shxshxshxshx/VoronToolheadPCB/README.md

USB Toolhead Board for Voron Stealthburner

**WIP | DO NOT ORDER**

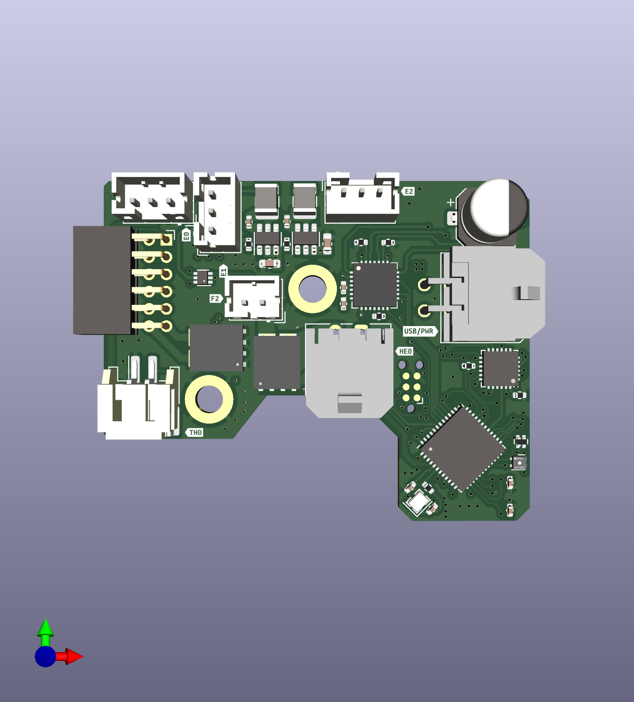
[picture p1: img/VoronToolheadPCB_Front.png]
Main PCB Front

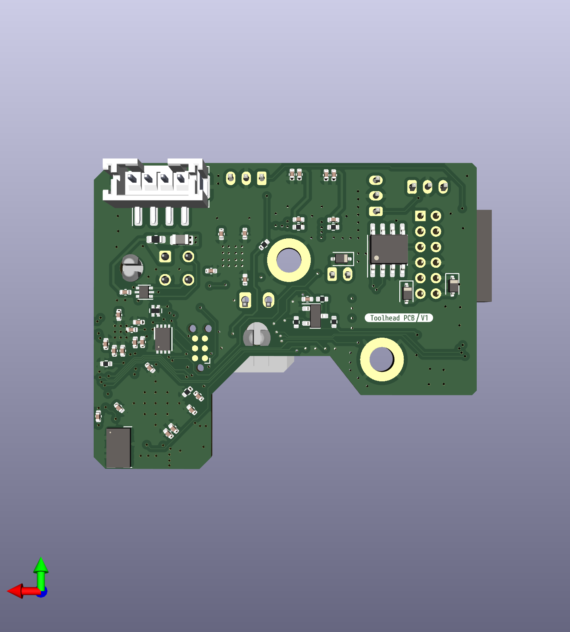
[picture p2: img/VoronToolheadPCB_Back.png]
Main PCB Back
