shxshxshxshx/VoronToolheadPCB/VoronToolheadPCB.kicad_pcb

## KiCad design VoronToolheadPCB.kicad_pcb (2023-10-27)

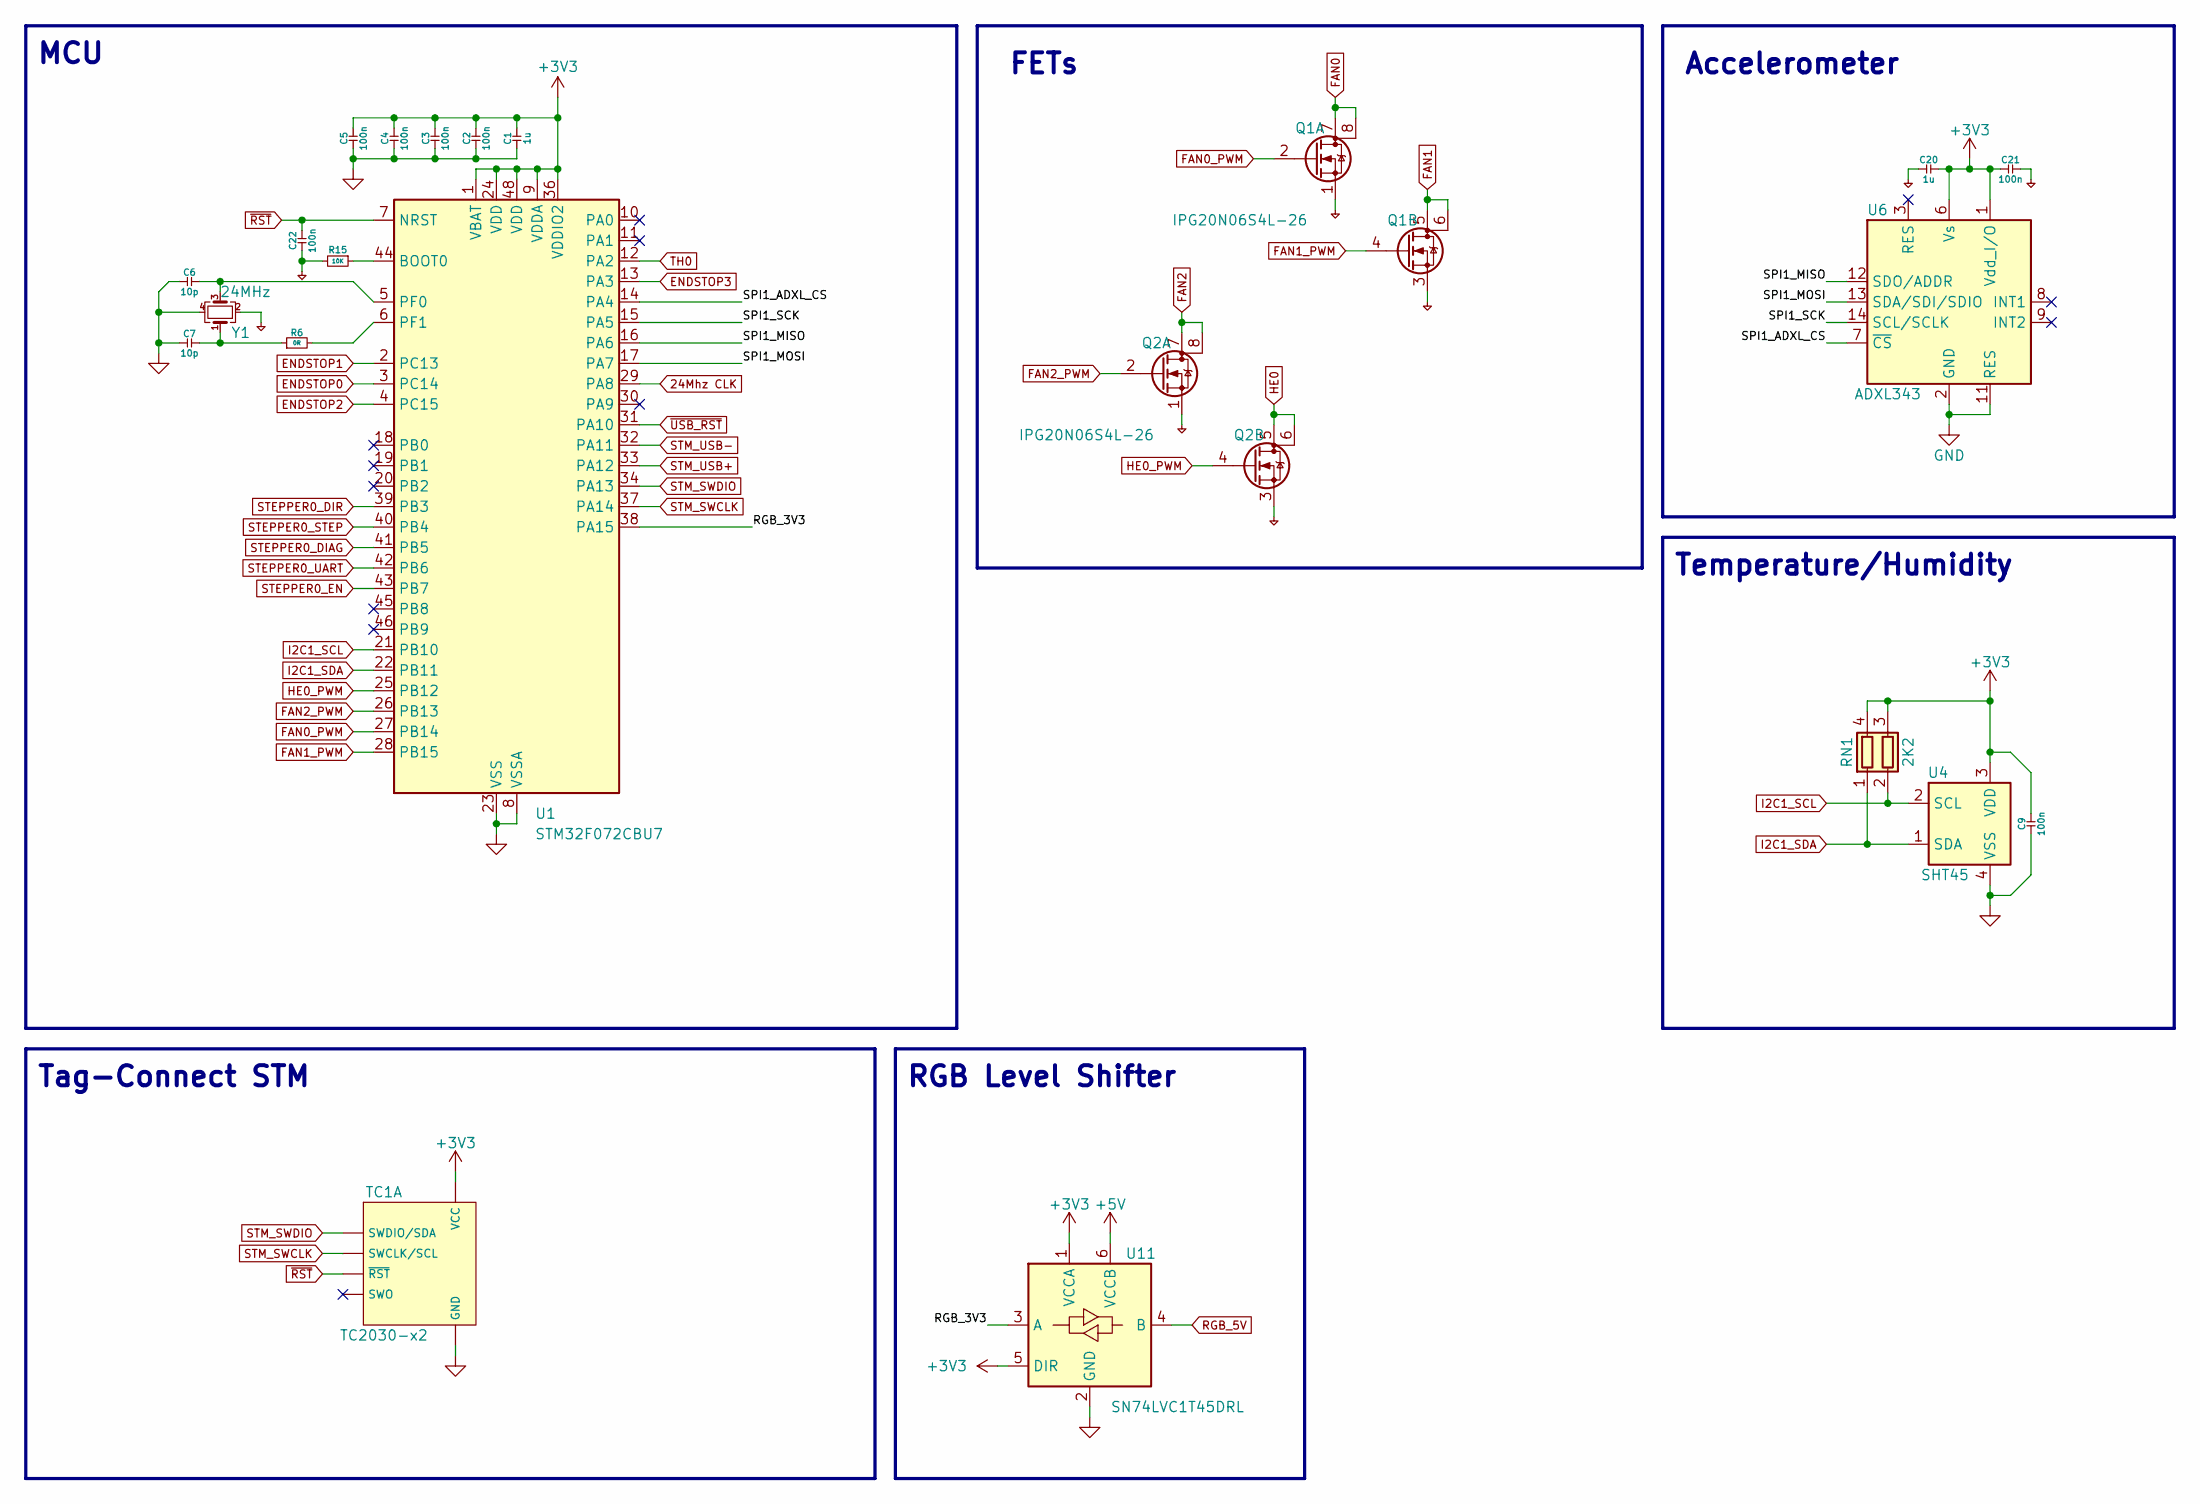
[picture p3: schematic mcu.kicad_sch]

Parts:
C1, C20: 1u; C_0402_1005Metric
C2, C3, C4, C5, C9, C21, C22: 100n; C_0402_1005Metric
C6, C7: 10p; C_0402_1005Metric
Q1, Q2: IPG20N06S4L-26; Infineon_PG-TDSON-8-4
R6: 0R; R_0402_1005Metric
R15: 10K; R_0402_1005Metric
RN1: 2K2; R_Array_Convex_2x0402
TC1: TC2030-x2; Double_Tag-Connect_TC2030-IDC-NL
U1: STM32F072CBU7; QFN-48-1EP_7x7mm_P0.5mm_EP5.6x5.6mm
U4: SHT45; Sensirion_DFN-4_1.5x1.5mm_P0.8mm_SHT4x_NoCentralPad
U6: ADXL343; LGA-14_3x5mm_P0.8mm_LayoutBorder1x6y
U11: SN74LVC1T45DRL; SOT-563
Y1: 24MHz; Crystal_SMD_2016-4Pin_2.0x1.6mm

Connections:
24Mhz CLK: U1.29 (PA8); also elsewhere on the board
+3V3: C1.2, C2.2, C3.2, C4.2, C5.2, C9.2, C20.2, C21.1, RN1.3 (R2.2), RN1.4 (R1.2), TC1.1 (VCC), U1.1 (VBAT), U1.9 (VDDA), U1.24 (VDD), U1.36 (VDDIO2), U1.48 (VDD), U4.3 (VDD), U6.1 (Vdd_I/O), U6.6 (Vs), U11.1 (VCCA), U11.5 (DIR); also elsewhere on the board
+5V: U11.6 (VCCB); also elsewhere on the board
/MCU/RGB_3V3: U1.38 (PA15), U11.3 (A)
/MCU/SPI1_ADXL_CS: U1.14 (PA4), U6.7 (~CS)
/MCU/SPI1_MISO: U1.16 (PA6), U6.12 (SDO/ADDR)
/MCU/SPI1_MOSI: U1.17 (PA7), U6.13 (SDA/SDI/SDIO)
/MCU/SPI1_SCK: U1.15 (PA5), U6.14 (SCL/SCLK)
ENDSTOP0: U1.3 (PC14); also elsewhere on the board
ENDSTOP1: U1.2 (PC13); also elsewhere on the board
ENDSTOP2: U1.4 (PC15); also elsewhere on the board
ENDSTOP3: U1.13 (PA3); also elsewhere on the board
FAN0: Q1.7 (D), Q1.8 (D); also elsewhere on the board
FAN0_PWM: Q1.2 (G), U1.27 (PB14)
FAN1: Q1.5 (D), Q1.6 (D); also elsewhere on the board
FAN1_PWM: Q1.4 (G), U1.28 (PB15)
FAN2: Q2.7 (D), Q2.8 (D); also elsewhere on the board
FAN2_PWM: Q2.2 (G), U1.26 (PB13)
GND: C1.1, C2.1, C3.1, C4.1, C5.1, C6.1, C7.1, C9.1, C20.1, C21.2, C22.1, Q1.1 (S), Q1.3 (S), Q2.1 (S), Q2.3 (S), R15.2, TC1.5 (GND), U1.8 (VSSA), U1.23 (VSS), U1.35 (VSS), U1.47 (VSS), U1.49 (VSS), U4.4 (VSS), U6.2 (GND), U6.4 (GND), U6.5 (GND), U6.11 (RES), U11.2 (GND), Y1.2, Y1.4; also elsewhere on the board
HE0: Q2.5 (D), Q2.6 (D); also elsewhere on the board
HE0_PWM: Q2.4 (G), U1.25 (PB12)
I2C1_SCL: RN1.2 (R2.1), U1.21 (PB10), U4.2 (SCL)
I2C1_SDA: RN1.1 (R1.1), U1.22 (PB11), U4.1 (SDA)
unnamed: C7.2, R6.1, Y1.1
unnamed: R15.1, U1.44 (BOOT0)
unnamed: C6.2, U1.5 (PF0), Y1.3
unnamed: R6.2, U1.6 (PF1)
RGB_5V: U11.4 (B); also elsewhere on the board
STEPPER0_DIAG: U1.41 (PB5); also elsewhere on the board
STEPPER0_DIR: U1.39 (PB3); also elsewhere on the board
STEPPER0_EN: U1.43 (PB7); also elsewhere on the board
STEPPER0_STEP: U1.40 (PB4); also elsewhere on the board
STEPPER0_UART: U1.42 (PB6); also elsewhere on the board
STM_SWCLK: TC1.4 (SWCLK/SCL), U1.37 (PA14)
STM_SWDIO: TC1.2 (SWDIO/SDA), U1.34 (PA13)
STM_USB+: U1.33 (PA12); also elsewhere on the board
STM_USB-: U1.32 (PA11); also elsewhere on the board
TH0: U1.12 (PA2); also elsewhere on the board
~RST: C22.2, TC1.3 (~RST), U1.7 (NRST)
~USB_RST: U1.31 (PA10); also elsewhere on the board

Notes on the sheet:
MCU
Tag-Connect STM
Accelerometer
Temperature/Humidity
FETs
RGB Level Shifter

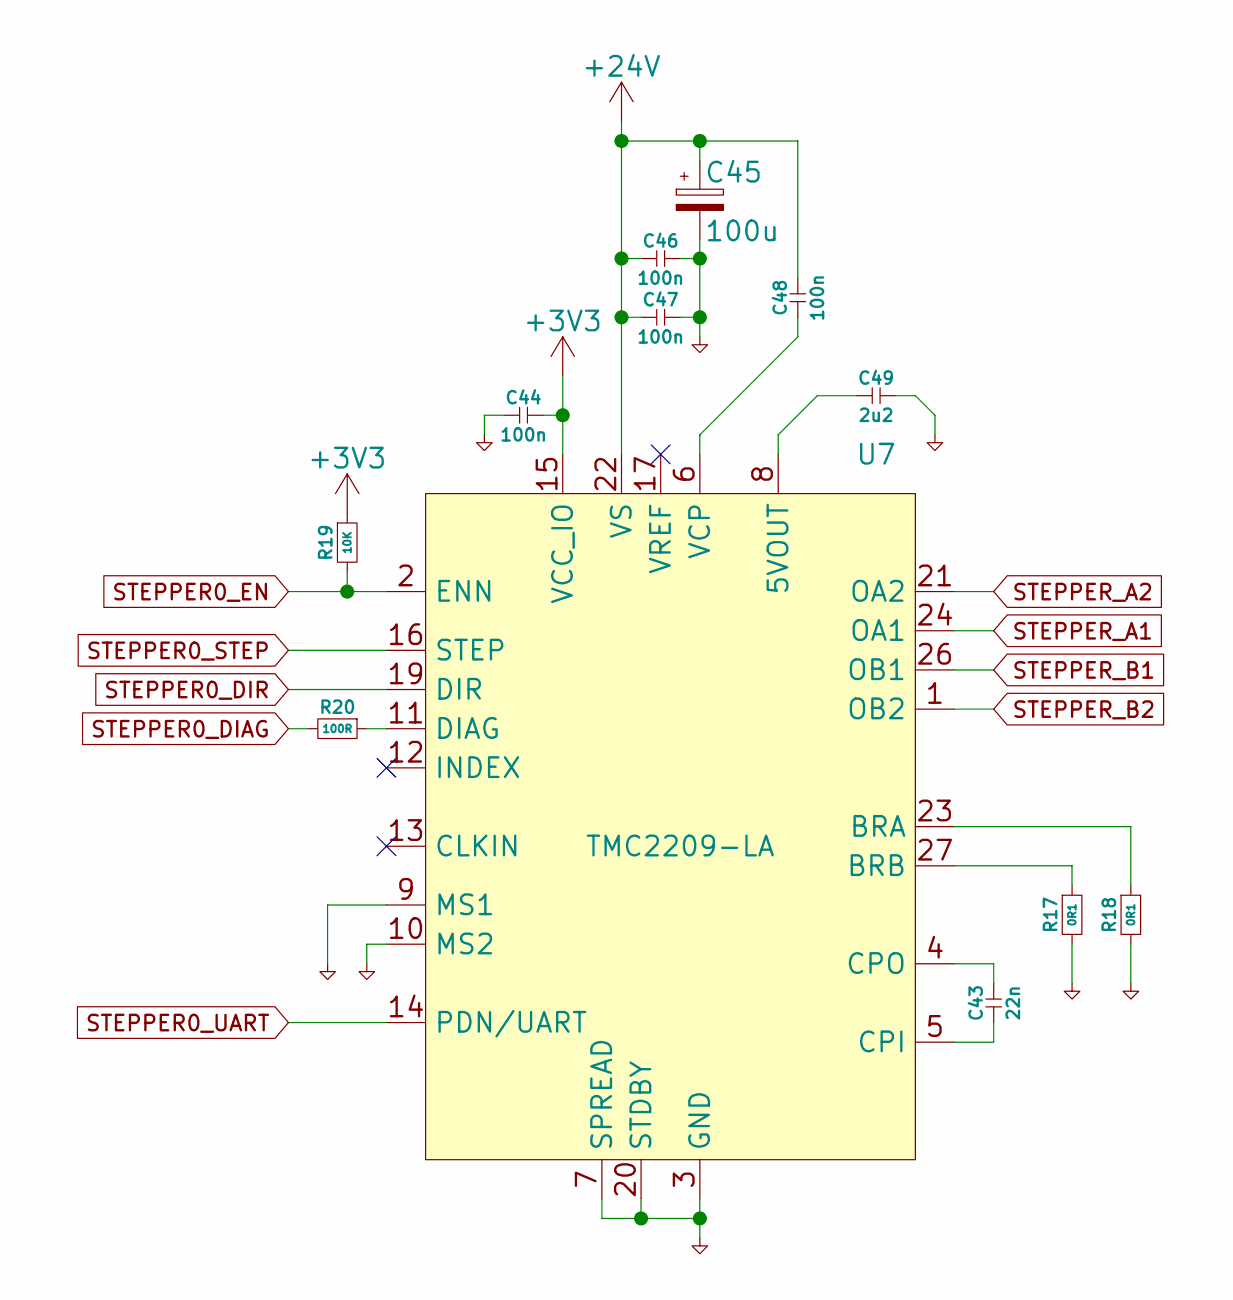
[picture p4: schematic stepper.kicad_sch]

Parts:
C43: 22n; C_0402_1005Metric
C44, C46, C47, C48: 100n; C_0402_1005Metric
C45: 100u; CP_Elec_6.3x7.7
C49: 2u2; C_0402_1005Metric
R17, R18: 0R1; R_0402_1005Metric
R19: 10K; R_0402_1005Metric
R20: 100R; R_0402_1005Metric
U7: TMC2209-LA; QFN-28-1EP_5x5mm_P0.5mm_EP3.75x3.75mm

Connections:
+3V3: C44.2, R19.1, U7.15 (VCC_IO); also elsewhere on the board
+24V: C45.1, C46.1, C47.1, C48.2, U7.22 (VS), U7.28 (VS); also elsewhere on the board
GND: C44.1, C45.2, C46.2, C47.2, C49.2, R17.2, R18.2, U7.3 (GND), U7.7 (SPREAD), U7.9 (MS1), U7.10 (MS2), U7.18 (GND), U7.20 (STDBY), U7.25, U7.29 (EP); also elsewhere on the board
unnamed: C49.1, U7.8 (5VOUT)
unnamed: R18.1, U7.23 (BRA)
unnamed: R17.1, U7.27 (BRB)
unnamed: C43.1, U7.5 (CPI)
unnamed: C43.2, U7.4 (CPO)
unnamed: R20.1, U7.11 (DIAG)
unnamed: C48.1, U7.6 (VCP)
STEPPER0_DIAG: R20.2; also elsewhere on the board
STEPPER0_DIR: U7.19 (DIR); also elsewhere on the board
STEPPER0_EN: R19.2, U7.2 (ENN); also elsewhere on the board
STEPPER0_STEP: U7.16 (STEP); also elsewhere on the board
STEPPER0_UART: U7.14 (PDN/UART); also elsewhere on the board
STEPPER_A1: U7.24 (OA1); also elsewhere on the board
STEPPER_A2: U7.21 (OA2); also elsewhere on the board
STEPPER_B1: U7.26 (OB1); also elsewhere on the board
STEPPER_B2: U7.1 (OB2); also elsewhere on the board

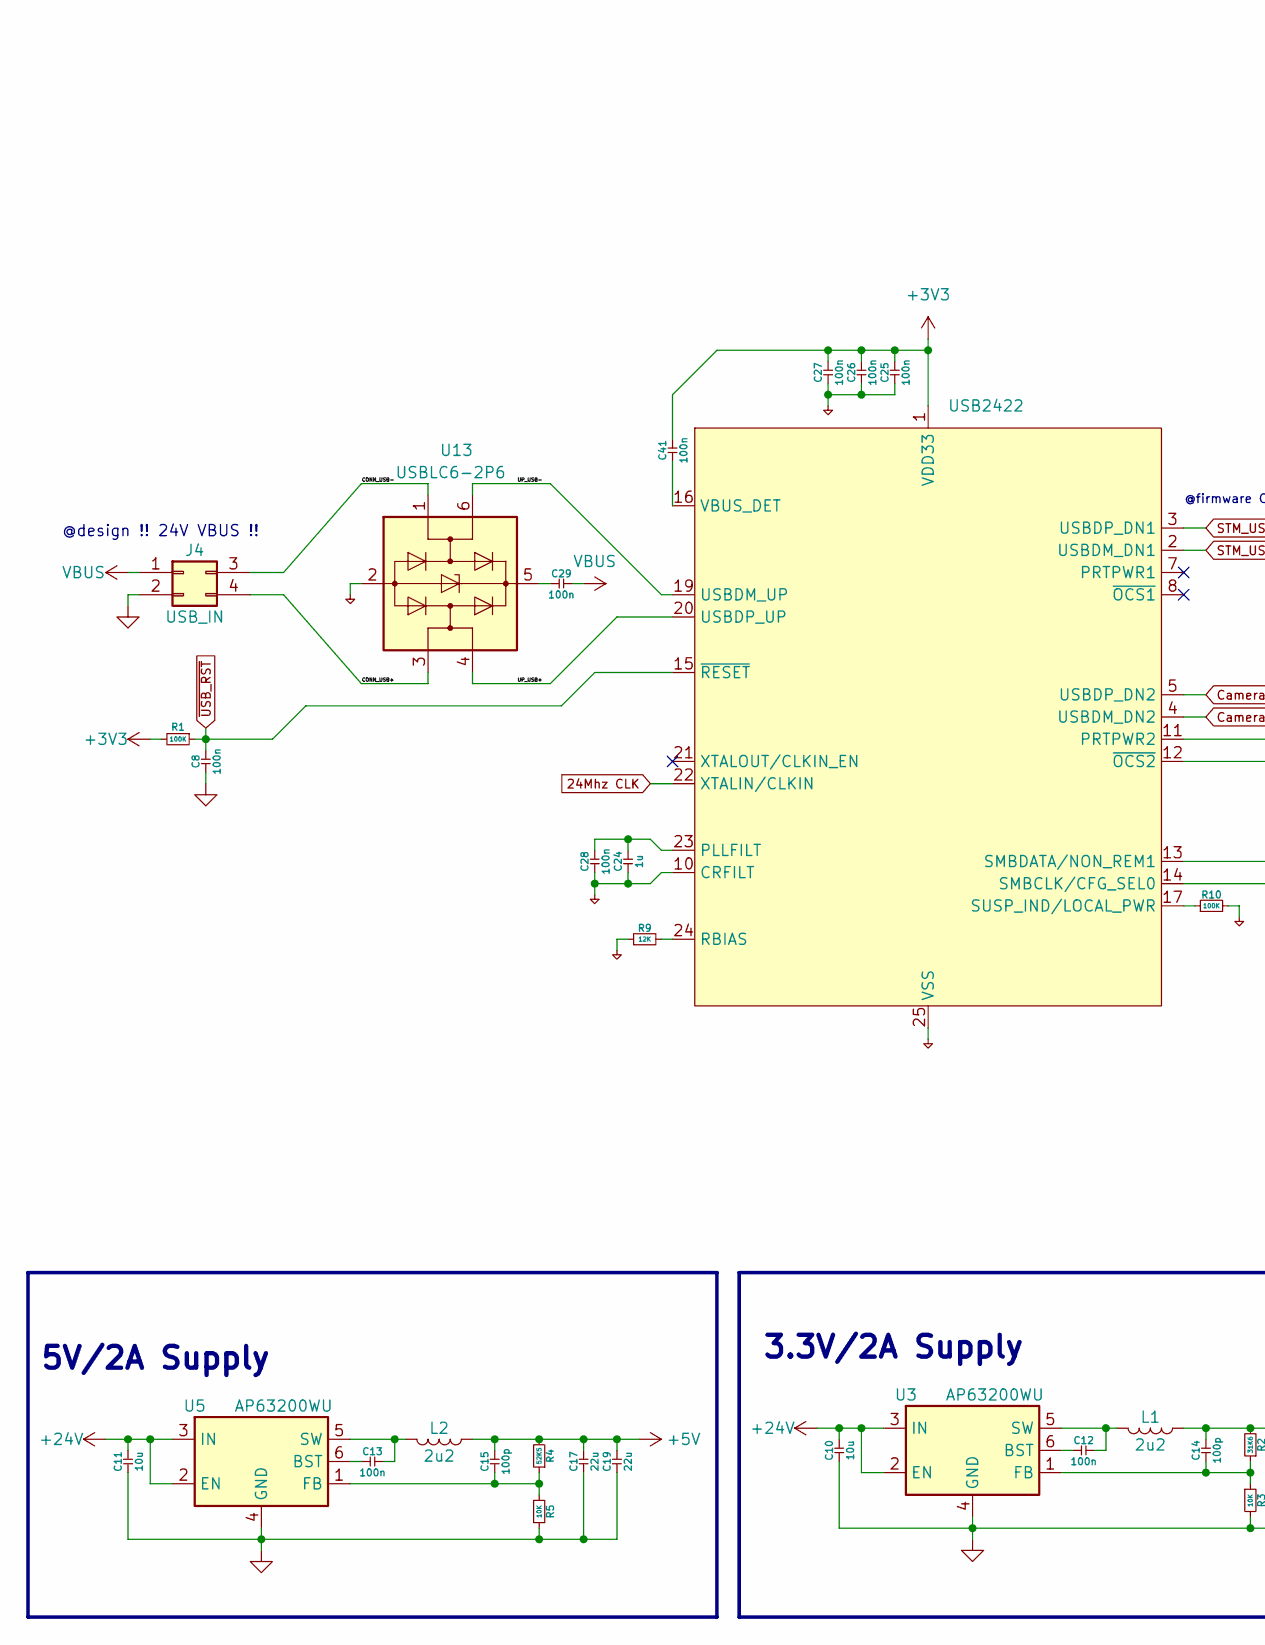
[picture p5: schematic usb.kicad_sch, part in row 1, column 1]

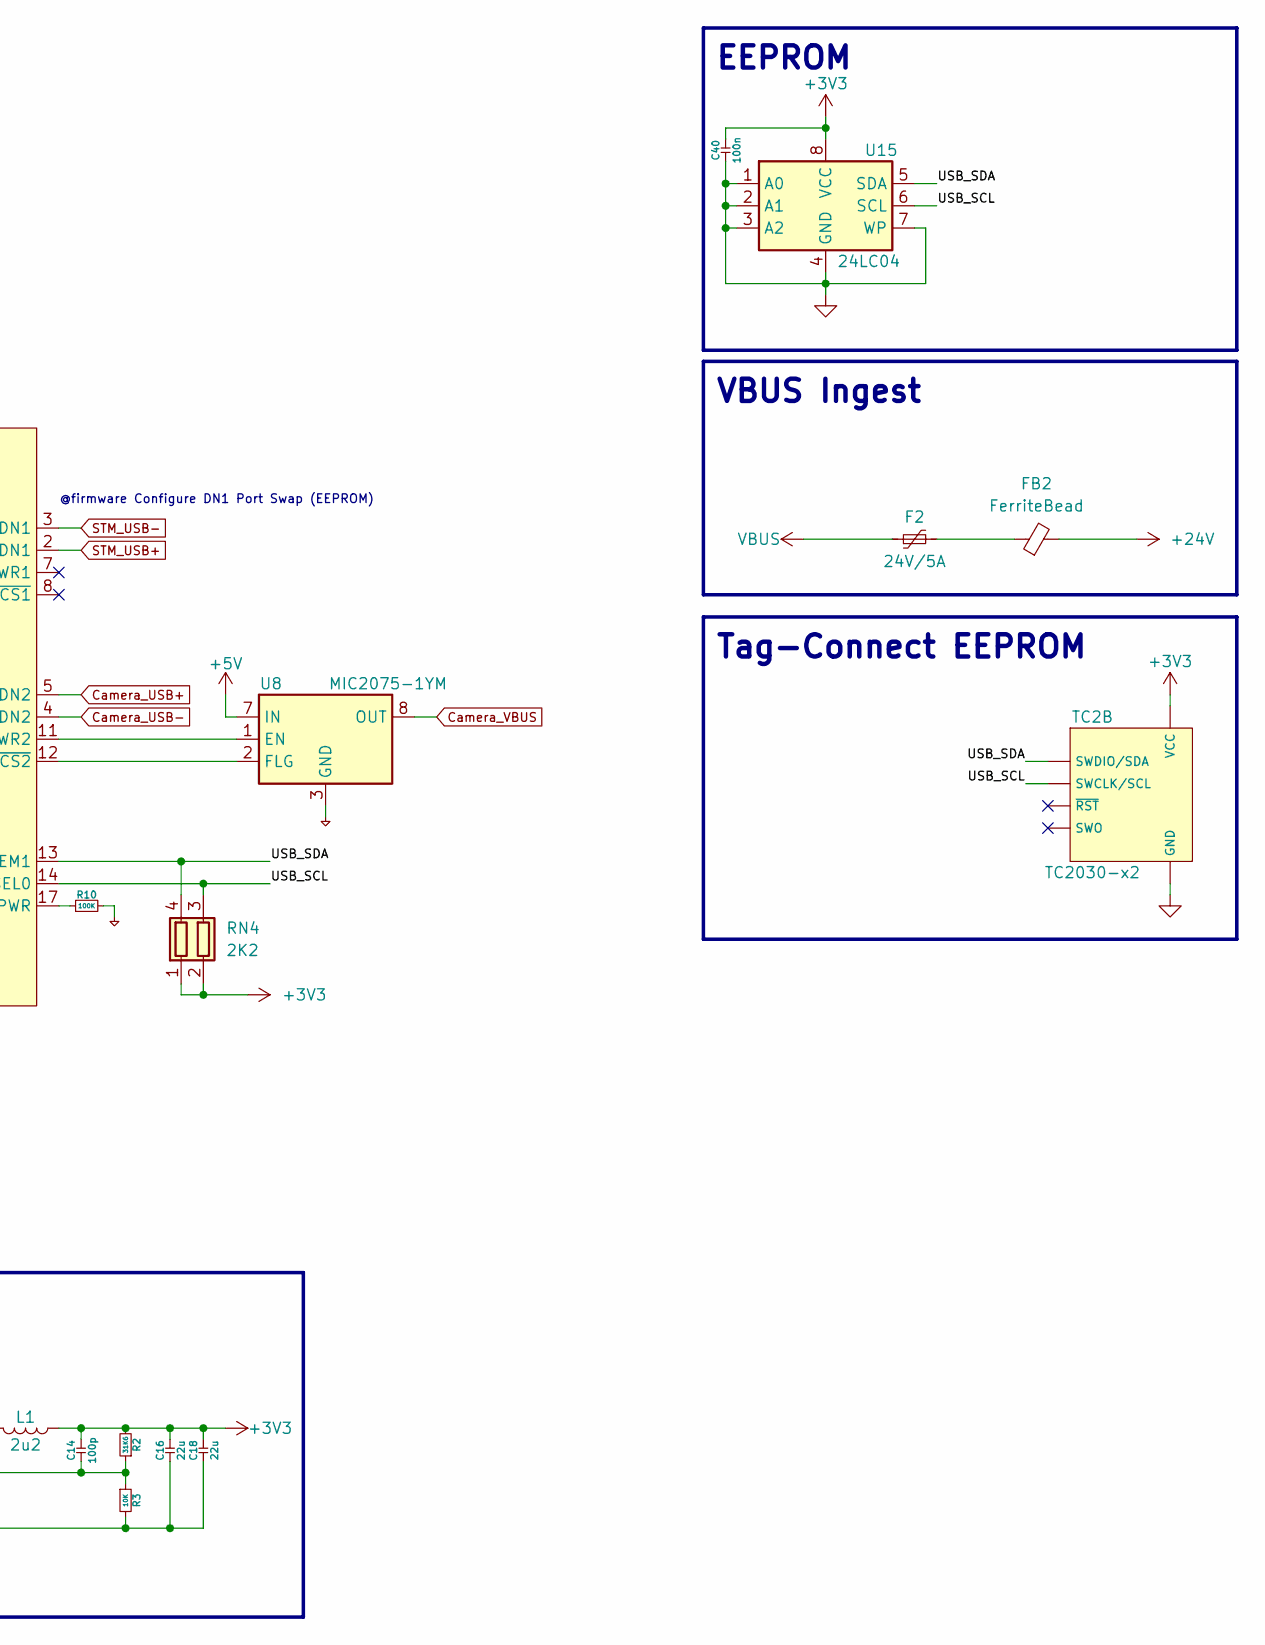
[picture p6: schematic usb.kicad_sch, part in row 1, column 2]

Parts:
C8, C12, C13, C25, C26, C27, C28, C29, C40, C41: 100n; C_0402_1005Metric
C10, C11: 10u; C_0603_1608Metric
C14, C15: 100p; C_0402_1005Metric
C16, C17, C18, C19: 22u; C_0402_1005Metric
C24: 1u; C_0402_1005Metric
F2: 24V/5A; Fuse_0603_1608Metric
FB2: FerriteBead; L_0805_2012Metric
J4: USB_IN; Molex_Micro-Fit_3.0_43045-0400_2x02_P3.00mm_Horizontal
L1, L2: 2u2; L_1210_3225Metric
R1, R10: 100K; R_0402_1005Metric
R2: 31K6; R_0402_1005Metric
R3, R5: 10K; R_0402_1005Metric
R4: 52K5; R_0402_1005Metric
R9: 12K; R_0402_1005Metric
RN4: 2K2; R_Array_Convex_2x0402
TC2: TC2030-x2; Double_Tag-Connect_TC2030-IDC-NL
U2: USB2422; QFN-24-1EP_4x4mm_P0.5mm_EP2.6x2.6mm
U3, U5: AP63200WU; TSOT-23-6
U8: MIC2075-1YM; SOIC-8_3.9x4.9mm_P1.27mm
U13: USBLC6-2P6; SOT-666
U15: 24LC04; DFN-8-1EP_3x2mm_P0.5mm_EP1.36x1.46mm

Connections:
24Mhz CLK: U2.22 (XTALIN/CLKIN); also elsewhere on the board
+3V3: C14.2, C16.2, C18.2, C25.2, C26.2, C27.2, C40.2, C41.2, L1.1, R1.2, R2.2, RN4.1 (R1.1), RN4.2 (R2.1), U2.1 (VDD33), U2.9 (VDD33), U2.18 (VDD33), U15.8 (VCC); also elsewhere on the board
+5V: C15.2, C17.2, C19.2, L2.2, R4.2, U8.7 (IN); also elsewhere on the board
+24V: C10.2, C11.2, FB2.2, U3.2 (EN), U3.3 (IN), U5.2 (EN), U5.3 (IN); also elsewhere on the board
/USB/CONN_USB+: J4.4, U13.3 (I/O2)
/USB/CONN_USB-: J4.3, U13.1 (I/O1)
/USB/UP_USB+: U2.20 (USBDP_UP), U13.4 (I/O2)
/USB/UP_USB-: U2.19 (USBDM_UP), U13.6 (I/O1)
/USB/USB_SCL: RN4.3 (R2.2), U2.14 (SMBCLK/CFG_SEL0), U15.6 (SCL); also elsewhere on the board
/USB/USB_SDA: RN4.4 (R1.2), U2.13 (SMBDATA/NON_REM1), U15.5 (SDA); also elsewhere on the board
Camera_USB+: U2.5 (USBDP_DN2); also elsewhere on the board
Camera_USB-: U2.4 (USBDM_DN2); also elsewhere on the board
Camera_VBUS: U8.6 (OUT), U8.8 (OUT); also elsewhere on the board
GND: C8.1, C10.1, C11.1, C16.1, C17.1, C18.1, C19.1, C24.1, C25.1, C26.1, C27.1, C28.1, C40.1, J4.2, R3.2, R5.2, R9.1, R10.2, U2.10 (CRFILT), U2.25 (VSS), U3.4 (GND), U5.4 (GND), U8.3 (GND), U13.2 (GND), U15.1 (A0), U15.2 (A1), U15.3 (A2), U15.4 (GND), U15.7 (WP), U15.9; also elsewhere on the board
unnamed: F2.2, FB2.1
unnamed: C24.2, C28.2, U2.23 (PLLFILT)
unnamed: U2.11 (PRTPWR2), U8.1 (EN)
unnamed: R9.2, U2.24 (RBIAS)
unnamed: R10.1, U2.17 (SUSP_IND/LOCAL_PWR)
unnamed: C41.1, U2.16 (VBUS_DET)
unnamed: U2.12 (~OCS2), U8.2 (FLG)
unnamed: C12.1, U3.6 (BST)
unnamed: C14.1, R2.1, R3.1, U3.1 (FB)
unnamed: C12.2, L1.2, U3.5 (SW)
unnamed: C13.1, U5.6 (BST)
unnamed: C15.1, R4.1, R5.1, U5.1 (FB)
unnamed: C13.2, L2.1, U5.5 (SW)
unnamed: C29.1, U13.5 (VBUS)
STM_USB+: U2.2 (USBDM_DN1); also elsewhere on the board
STM_USB-: U2.3 (USBDP_DN1); also elsewhere on the board
VBUS: C29.2, F2.1, J4.1
~USB_RST: C8.2, R1.1, U2.15 (~RESET); also elsewhere on the board

Notes on the sheet:
@design !! 24V VBUS !!
VBUS Ingest
3.3V/2A Supply
5V/2A Supply
EEPROM
Tag-Connect EEPROM
@firmware Configure DN1 Port Swap (EEPROM)

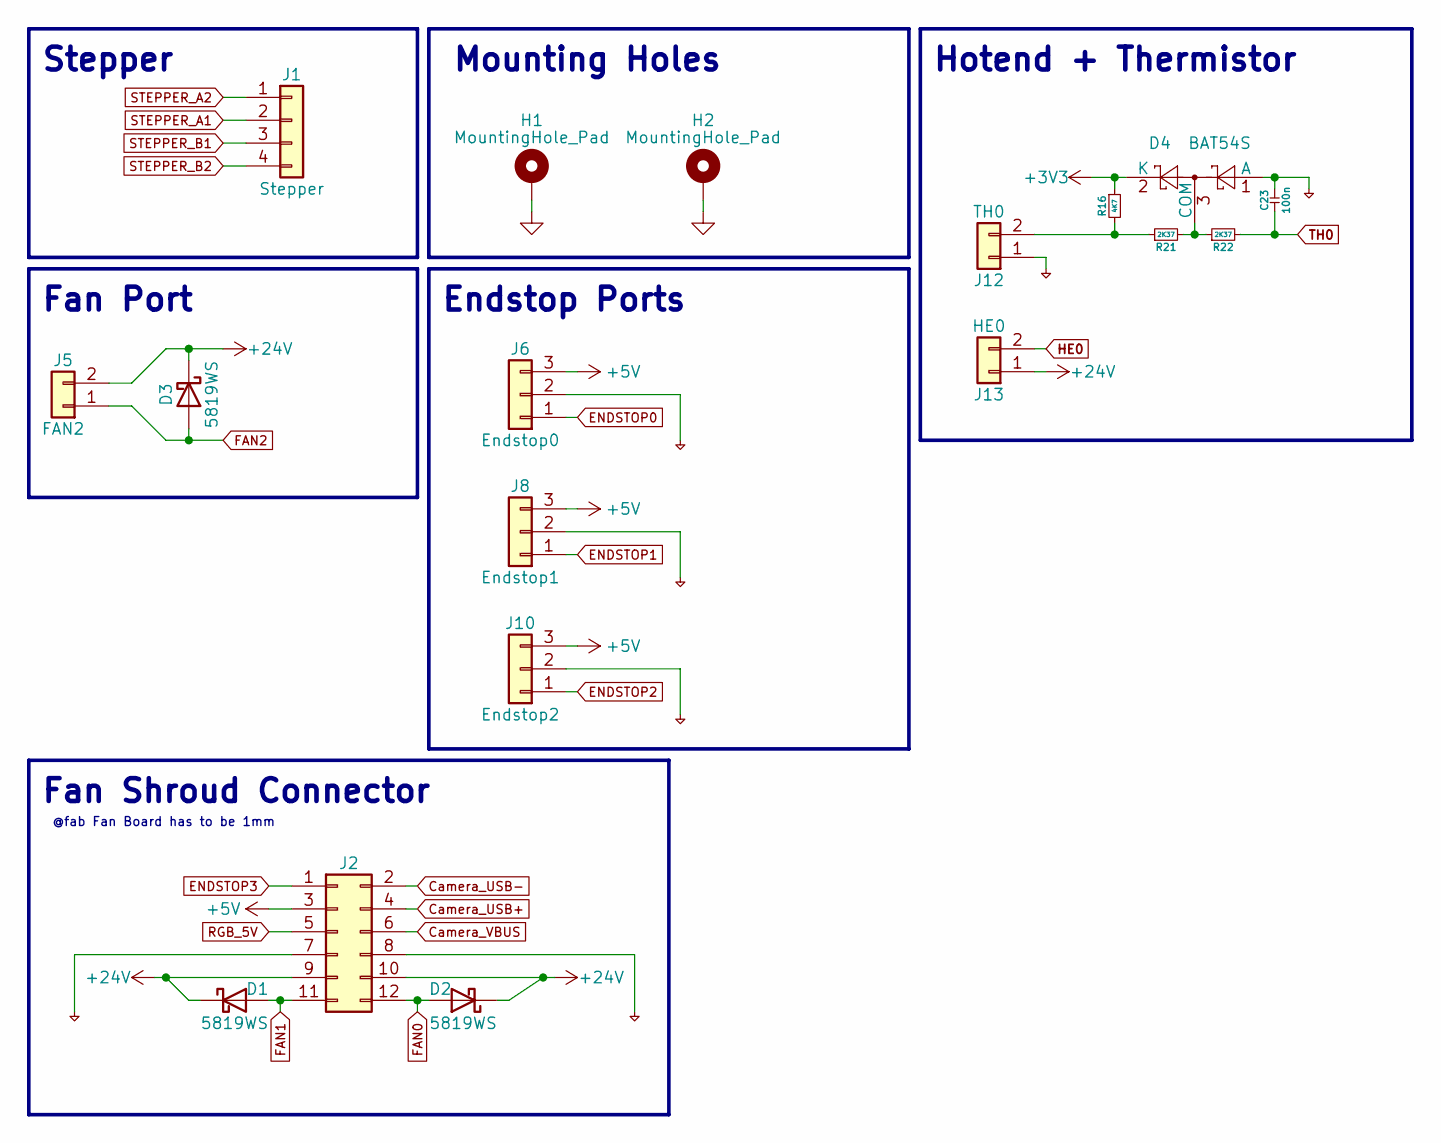
[picture p7: schematic connectors.kicad_sch]

Parts:
C23: 100n; C_0402_1005Metric
D1, D2, D3: 5819WS; D_SOD-323
D4: BAT54S; SOT-23
H1, H2: MountingHole_Pad; MountingHole_3.2mm_M3_DIN965_Pad
J1: Stepper; JST_PH_B4B-PH-SM4-TB_1x04-1MP_P2.00mm_Vertical
J2: Conn_02x06_Odd_Even; PinSocket_2x06_P2.00mm_Horizontal
J5: FAN2; JST_PH_B2B-PH-K_1x02_P2.00mm_Vertical
J6: Endstop0; JST_PH_B3B-PH-K_1x03_P2.00mm_Vertical
J8: Endstop1; JST_PH_B3B-PH-K_1x03_P2.00mm_Vertical
J10: Endstop2; JST_PH_B3B-PH-K_1x03_P2.00mm_Vertical
J12: TH0; JST_PH_S2B-PH-SM4-TB_1x02-1MP_P2.00mm_Horizontal
J13: HE0; Molex_Micro-Fit_3.0_43650-0200_1x02_P3.00mm_Horizontal
R16: 4K7; R_0402_1005Metric
R21, R22: 2K37; R_0402_1005Metric

Connections:
+3V3: D4.2 (K), R16.1; also elsewhere on the board
+5V: J2.3, J6.3, J8.3, J10.3; also elsewhere on the board
+24V: D1.1 (K), D2.1 (K), D3.1 (K), J2.9, J2.10, J5.2, J13.1; also elsewhere on the board
Camera_USB+: J2.4; also elsewhere on the board
Camera_USB-: J2.2; also elsewhere on the board
Camera_VBUS: J2.6; also elsewhere on the board
ENDSTOP0: J6.1; also elsewhere on the board
ENDSTOP1: J8.1; also elsewhere on the board
ENDSTOP2: J10.1; also elsewhere on the board
ENDSTOP3: J2.1; also elsewhere on the board
FAN0: D2.2 (A), J2.12; also elsewhere on the board
FAN1: D1.2 (A), J2.11; also elsewhere on the board
FAN2: D3.2 (A), J5.1; also elsewhere on the board
GND: C23.2, D4.1 (A), H1.1, H2.1, J1.MP, J2.7, J2.8, J6.2, J8.2, J10.2, J12.1; also elsewhere on the board
HE0: J13.2; also elsewhere on the board
unnamed: D4.3 (COM), R21.2, R22.1
unnamed: J12.2, R16.2, R21.1
RGB_5V: J2.5; also elsewhere on the board
STEPPER_A1: J1.2; also elsewhere on the board
STEPPER_A2: J1.1; also elsewhere on the board
STEPPER_B1: J1.3; also elsewhere on the board
STEPPER_B2: J1.4; also elsewhere on the board
TH0: C23.1, R22.2; also elsewhere on the board

Notes on the sheet:
Fan Shroud Connector
Fan Port
Hotend + Thermistor
@fab Fan Board has to be 1mm
Endstop Ports
Mounting Holes
Stepper

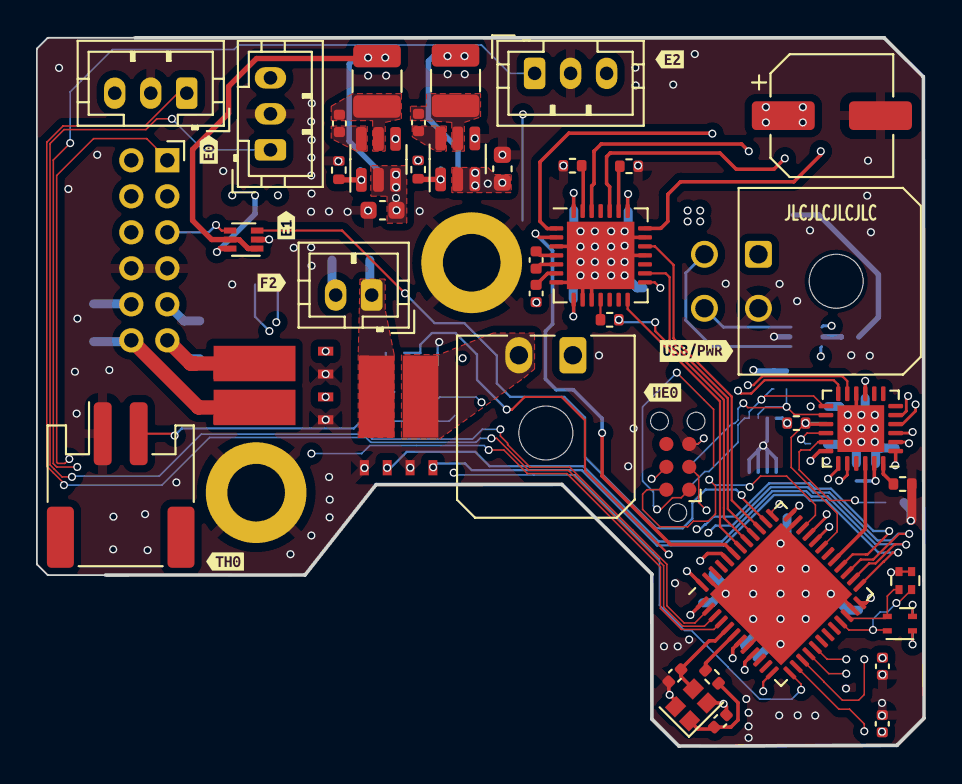
[picture p8: board VoronToolheadPCB.kicad_pcb from above]

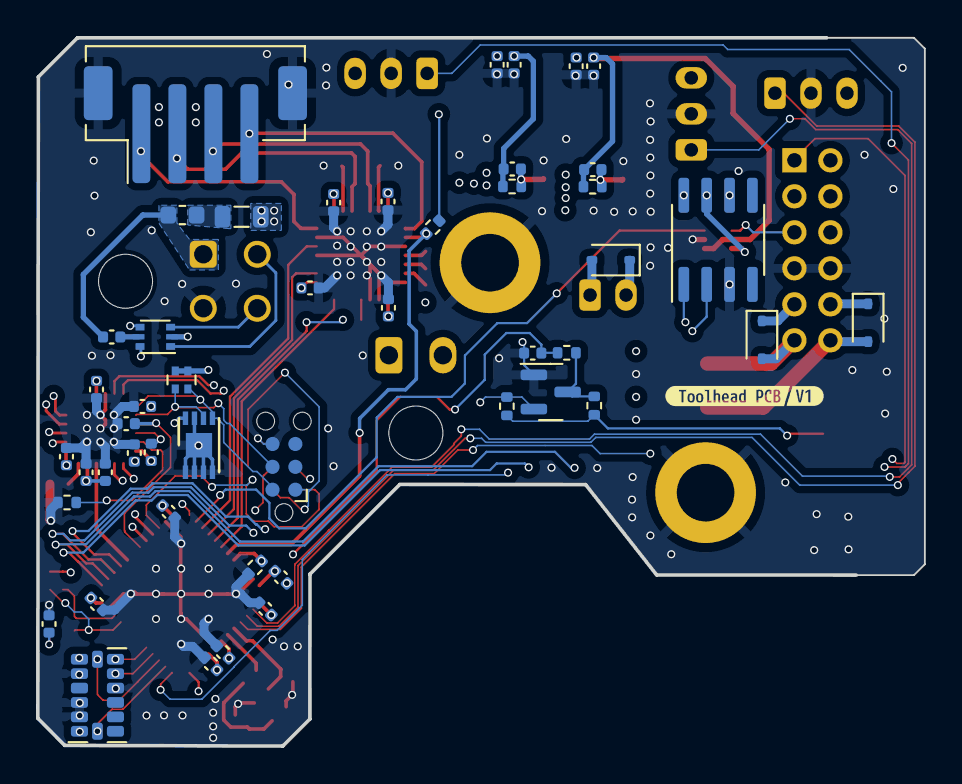
[picture p9: board VoronToolheadPCB.kicad_pcb from below]

Board: 6 copper layers, 49.3 x 39.3 mm, 99 parts (49 on the bottom side), 78 nets.

Other parts of the board:
kibuzzard-651F31B1: G***; kibuzzard-651F31B1
kibuzzard-651F31F1: G***; kibuzzard-651F31F1
kibuzzard-651F32E5: G***; kibuzzard-651F32E5
kibuzzard-651F32EB: G***; kibuzzard-651F32EB
kibuzzard-651F311C: G***; kibuzzard-651F311C
kibuzzard-651F318A: G***; kibuzzard-651F318A
kibuzzard-651F3142: G***; kibuzzard-651F3142
kibuzzard-651F3160: G***; kibuzzard-651F3160
kibuzzard-651F3191: G***; kibuzzard-651F3191
